ricardomdesa/espresso-mach-mod/pinout2-1500.png

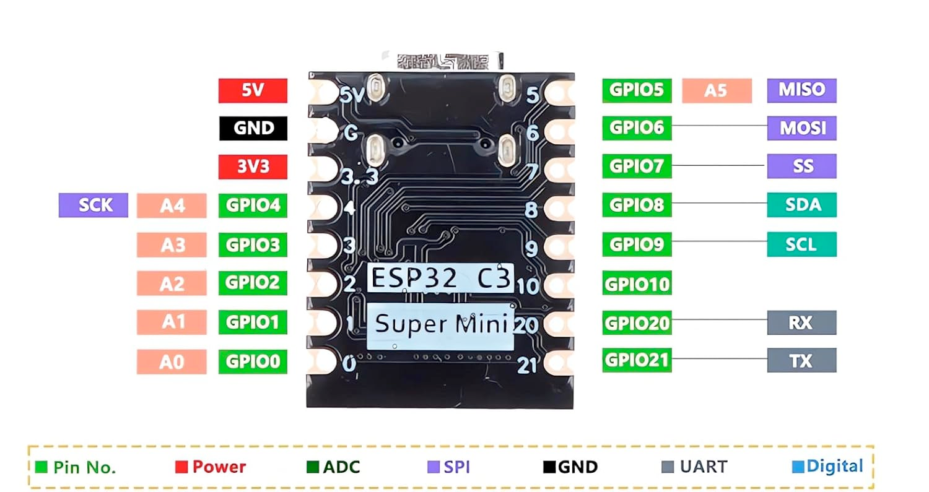
pinout2-1500.png
