ricardomdesa/espresso-mach-mod/hardware/espresso-board-mini/espresso-board-mini.step

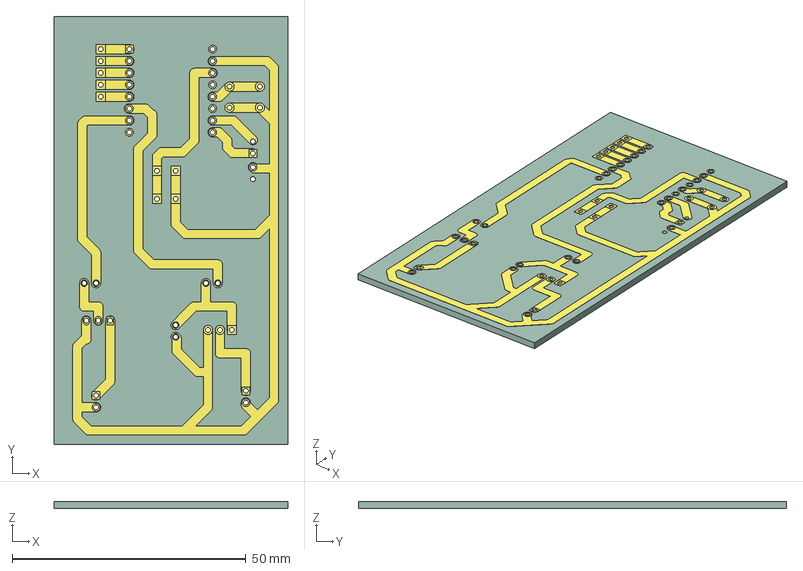
[picture p2: CAD file, 2026-09-21]
hardware/espresso-board-mini/espresso-board-mini.step
50.0 x 91.5 x 1.59 mm
espresso-board-mini-unsaved-export-MyEvqq_copper
espresso-board-mini-unsaved-export-MyEvqq_pad
espresso-board-mini-unsaved-export-MyEvqq_PCB
