ricardomdesa/espresso-mach-mod/hardware/step-down-V/step-down-V.kicad_pcb

## KiCad design hardware/step-down-V/step-down-V.kicad_pcb (2026-09-21)

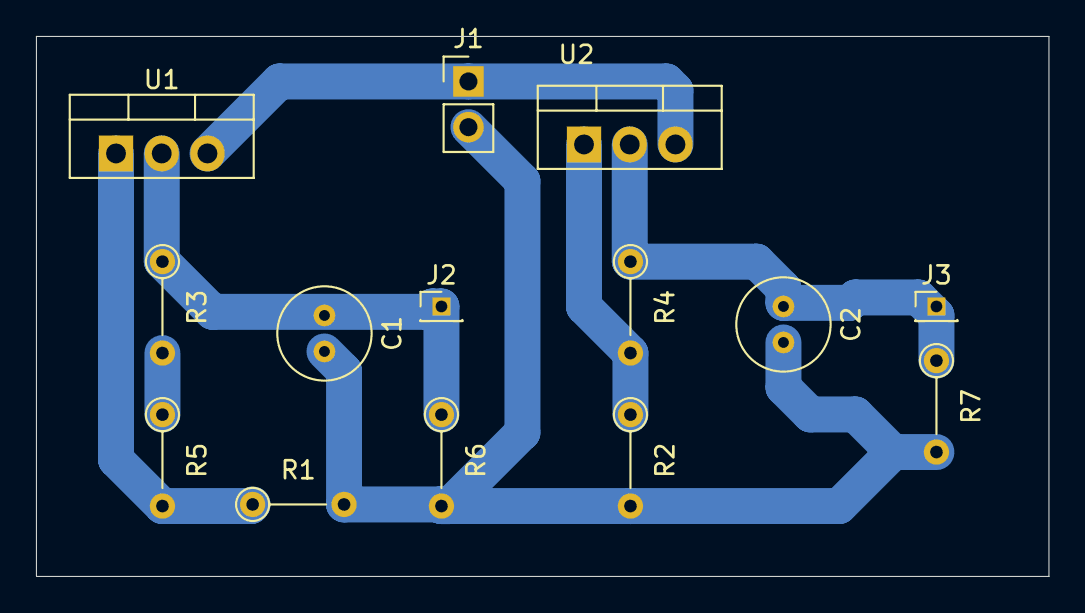
[picture p3: board step-down-V.kicad_pcb from above]

Board: 2 copper layers, 56.2 x 30.0 mm, 14 parts (0 on the bottom side), 7 nets.

Parts:
C1, C2: C_Polarized; C_Radial_D5.0mm_H5.0mm_P2.00mm
J1: Vin 12V; PinHeader_1x02_P2.54mm_Vertical
J2, J3: Conn_01x01_Socket; PinHeader_1x01_P1.27mm_Vertical
R1: 470; R_Axial_DIN0204_L3.6mm_D1.6mm_P5.08mm_Vertical
R2: 330; R_Axial_DIN0204_L3.6mm_D1.6mm_P5.08mm_Vertical
R3: 120; R_Axial_DIN0204_L3.6mm_D1.6mm_P5.08mm_Vertical
R4: 260; R_Axial_DIN0204_L3.6mm_D1.6mm_P5.08mm_Vertical
R5: 20; R_Axial_DIN0204_L3.6mm_D1.6mm_P5.08mm_Vertical
R6, R7: 1K; R_Axial_DIN0204_L3.6mm_D1.6mm_P5.08mm_Vertical
U1, U2: LM317_TO-220; TO-220-3_Vertical

Connections:
GND: C1.2, C2.2, J1.2, R1.2, R2.2, R6.2, R7.2
unnamed: J1.1, U1.3 (VI), U2.3 (VI)
unnamed: C1.1, J2.1 (Pin_1_1), R3.1, R6.1, U1.2 (VO)
unnamed: C2.1, J3.1 (Pin_1_1), R4.1, R7.1, U2.2 (VO)
unnamed: R3.2, R5.1
unnamed: R1.1, R5.2, U1.1 (ADJ)
unnamed: R2.1, R4.2, U2.1 (ADJ)
