ricardomdesa/espresso-mach-mod/hardware/espresso-board-mini/espresso-board-mini.kicad_pcb

## KiCad design hardware/espresso-board-mini/espresso-board-mini.kicad_pcb (2026-09-21)

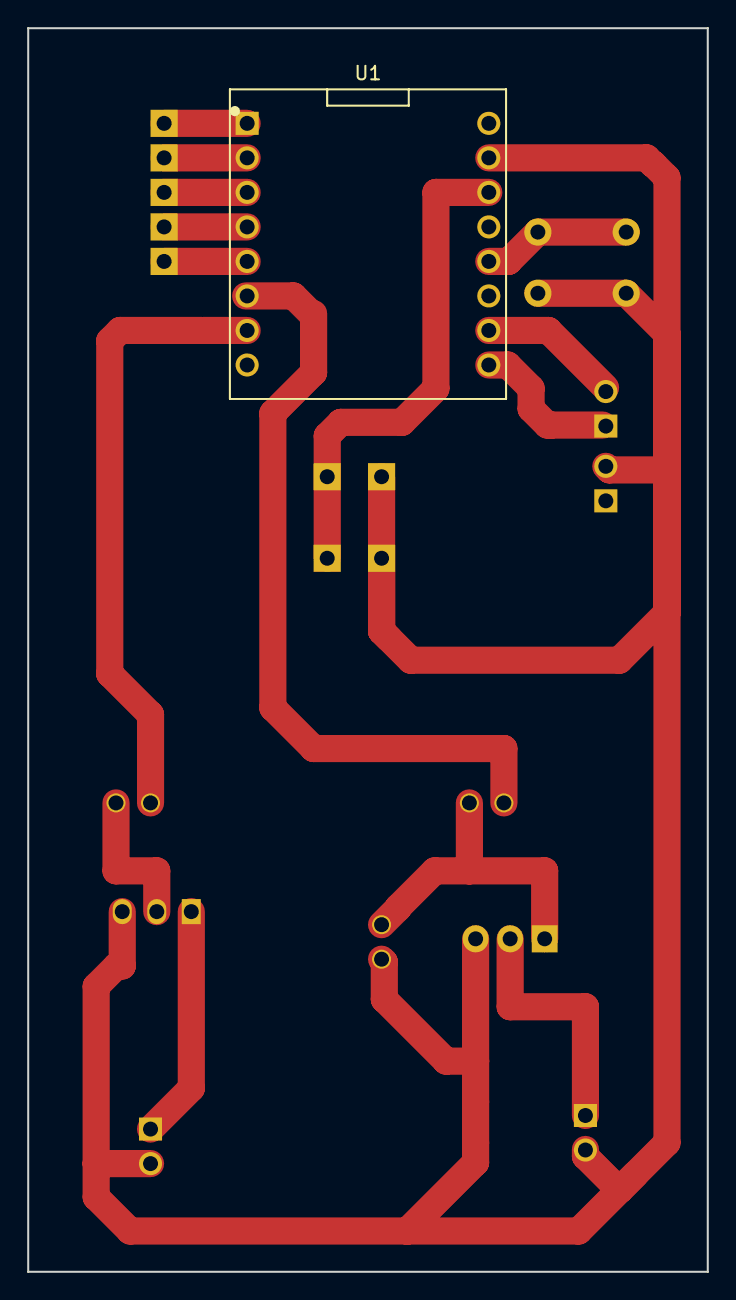
[picture p4: board espresso-board-mini.kicad_pcb from above]

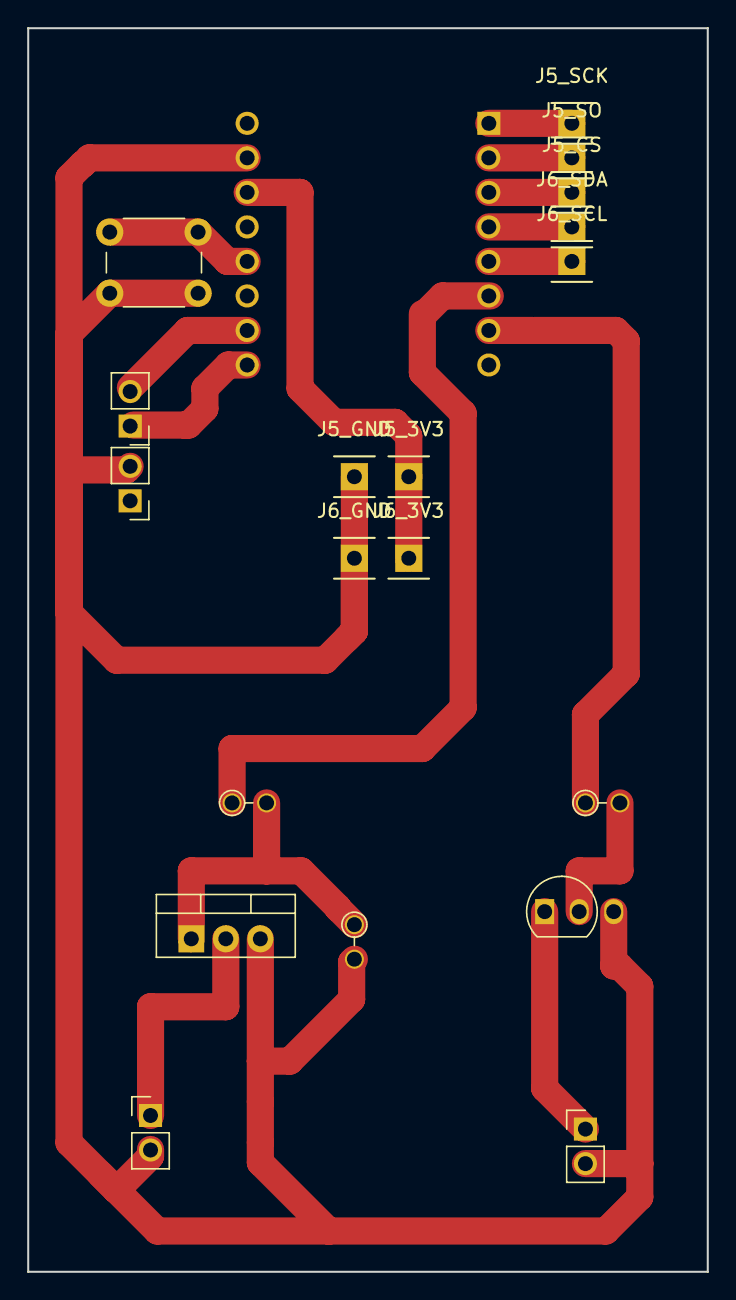
[picture p5: board espresso-board-mini.kicad_pcb from below]

Board: 2 copper layers, 50.0 x 91.5 mm, 10 parts (9 on the bottom side), 7 nets.

Parts:
J5_3V3: J_THERMO_3V3
J5_CS: THERMO_CS
J5_GND: J_THERMO_GND
J5_SCK: THERMO_SCK
J5_SO: THERMO_SO
J6_3V3: J_OLED_3V3
J6_GND: J_OLED_GND
J6_SCL: OLED_SCL
J6_SDA: OLED_SDA
U1: ESP32C3_SuperMini; ESP32C3_SuperMini_2x8_P2.54mm

Connections:
+3V3: J5_3V3.1, J6_3V3.1, U1.3 (3V3)
GND: J5_GND.1, J6_GND.1, U1.2 (GND)
OLED_SCL: J6_SCL.1, U1.13 (GPIO9)
OLED_SDA: J6_SDA.1, U1.12 (GPIO8)
THERMO_CS: J5_CS.1, U1.11 (GPIO7)
THERMO_SCK: J5_SCK.1, U1.9 (GPIO5)
THERMO_SO: J5_SO.1, U1.10 (GPIO6)
