ricardomdesa/espresso-mach-mod/hardware/espresso-board/espresso-board.kicad_pcb

## KiCad design hardware/espresso-board/espresso-board.kicad_pcb (2026-09-16)

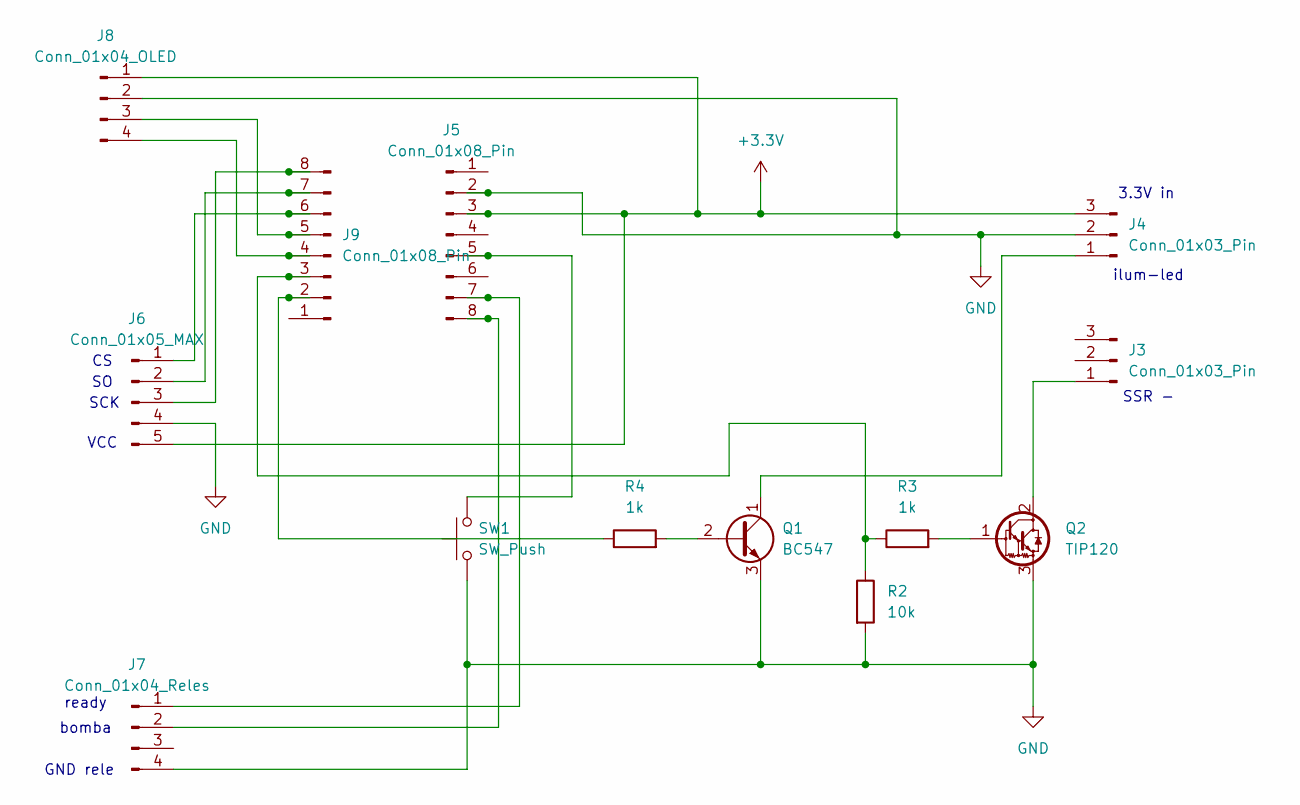
[picture p6: schematic espresso-board.kicad_sch]

Parts:
J3, J4: Conn_01x03_Pin; PinHeader_1x03_P2.54mm_Vertical
J5, J9: Conn_01x08_Pin; PinHeader_1x08_P2.54mm_Vertical
J6: Conn_01x05_MAX; PinHeader_1x05_P2.54mm_Vertical
J7: Conn_01x04_Reles; PinSocket_1x04_P2.54mm_Vertical
J8: Conn_01x04_OLED; PinSocket_1x04_P2.54mm_Vertical
Q1: BC547; TO-92_Inline
Q2: TIP120; TO-220-3_Vertical
R2: 10k; R_Axial_DIN0204_L3.6mm_D1.6mm_P2.54mm_Vertical
R3, R4: 1k; R_Axial_DIN0204_L3.6mm_D1.6mm_P2.54mm_Vertical
SW1: SW_Push; SW_PUSH_6mm

Connections:
+3.3V: J4.3, J5.3, J6.5, J8.1
GND: J4.2, J5.2, J6.4, J7.4, J8.2, Q1.3 (E), Q2.3 (E), R2.2, SW1.1
unnamed: J3.1 (Pin_1_1), Q2.2 (C)
unnamed: J4.1, Q1.1 (C)
unnamed: J5.5, SW1.2
unnamed: J5.7, J7.1
unnamed: J5.8, J7.2
unnamed: J6.1, J9.6
unnamed: J6.2, J9.7
unnamed: J6.3, J9.8
unnamed: J8.3, J9.5
unnamed: J8.4, J9.4
unnamed: J9.2, R4.1
unnamed: J9.3, R2.1, R3.1
unnamed: Q1.2 (B), R4.2
unnamed: Q2.1 (B), R3.2

Notes on the sheet:
ready
GND rele
SSR -
VCC
bomba
3.3V in
ilum-led
SCK

Board: 2 copper layers, 13 parts (1 on the bottom side), 16 nets, no tracks yet.
