ricardomdesa/espresso-mach-mod/include/pinos.h

#pragma once

// Pinagem validada em hardware (ESP32-C3 Super Mini) — mesma usada em outros
// projetos com este lote de placa.

// Único botão do produto. Clique curto liga/desliga o LED de iluminação; hold
// de 5 s sobe o AP de configuração (WifiProvisioner::requestAp). Ativo em LOW
// (pull-up interno, ligado ao GND).
#define PIN_BUTTON 3 // GPIO3 (botão tátil p/ GND, pull-up interno)

// GPIO20 é U0RXD por padrão. Com ARDUINO_USB_CDC_ON_BOOT=1 o Serial sai pelo
// USB-CDC, então a UART0 de hardware não é usada e o GPIO20 fica livre como
// saída digital. Não é strapping pin no ESP32-C3.
#define PIN_LED 20 // GPIO20 (saída p/ LED de iluminação, ativo HIGH)

// LED azul onboard da ESP32-C3 Super Mini: GPIO8, ativo em LOW. Usado como
// sinalizador de "modo setup" (pisca enquanto o AP está no ar). GPIO8 é
// strapping pin (precisa HIGH no boot) — só é dirigido depois do boot.
#define PIN_STATUS_LED 8
#define STATUS_LED_ON LOW
#define STATUS_LED_OFF HIGH

// Controle de temperatura: termopar tipo K via MAX6675 (SPI bit-bang) +
// SSR de aquecimento. Driver ativo no firmware (SensorMax6675 + PidController
// + HeaterOutput). A pressão segue em SensorFake — sensor de pressão é Fase 2.
#define PIN_THERMO_SCK 5 // GPIO5 — SPI SCK do amplificador do termopar (MAX6675)
#define PIN_THERMO_SO 6  // GPIO6 — SPI SO/MISO do amplificador (leitura)
#define PIN_THERMO_CS 7  // GPIO7 — SPI CS do amplificador

// GPIO10 -> driver TIP120 (Darlington NPN) que aciona o SSR GN 84136121
// (25A, entrada DC 3,5-32V). O GPIO só dá 3,3V e o datasheet do SSR pede
// min. 3,5V, por isso o estágio driver: GPIO10 --[1k]--> base do TIP120,
// resistor de 10k da base p/ GND (mantém o TIP120 cortado enquanto o GPIO
// flutua no boot). Coletor no "-" da entrada do SSR, emissor no GND comum,
// "+" da entrada do SSR no trilho de 5V (LM317 4,66V). Lógica não inverte:
// GPIO10 em HIGH satura o TIP120, puxa o "-" do SSR ao GND e o SSR conduz.
// Queda Vce(sat) do Darlington ~1V, o SSR vê ~3,6-4V — acima do limiar.
#define PIN_ACTUATOR 10 // GPIO10 — base do driver TIP120 do SSR de aquecimento (ativo HIGH)

// GPIO0 -> entrada de sinal do módulo de relé que aciona a bomba (liga/
// desliga). No ESP32-C3 o GPIO0 não é strapping pin (só serve de XTAL_32K_P,
// que não usamos), então fica livre como saída digital.
// O módulo de relé desta placa é ACTIVE-LOW: nível 0 fecha o relé (liga a
// bomba), nível 1 abre (desliga). GPIO0 tem pull-up interno no boot, então o
// relé fica desligado até o firmware assumir o pino.
#define PIN_PUMP 0      // GPIO0 — sinal do relé da bomba
#define PUMP_ACTIVE LOW // nível que liga a bomba (módulo active-low)
#define PUMP_IDLE HIGH  // nível que desliga a bomba

// GPIO1 -> relé "temperatura pronta". Fecha quando a caldeira chega no alvo
// (com histerese, ver controle.h) e abre se cair bem abaixo ou o sensor
// falhar. Serve pra extração manual sem o app: um contato seco sinalizando
// "pode puxar o shot". GPIO1 no ESP32-C3 é ADC1_CH1, sem função de strapping,
// livre como saída digital. Assume o MESMO módulo de relé active-low da bomba
// — A CONFIRMAR em bancada; se for active-high, inverter os dois defines.
#define PIN_READY 1       // GPIO1 — sinal do relé de "temperatura pronta"
#define READY_ACTIVE LOW  // nível que fecha o relé (temperatura ok)
#define READY_IDLE HIGH   // nível que abre o relé
