ricardomdesa/espresso-mach-mod/(commit log)

2026-08-19 feat: scaffold épico 1 — firmware OLED + navegação (ESP32-C3)
    Implementa SDD-001: driver SSD1306, DisplayModel como fonte única de
    dados, ScreenManager com 2 telas (leituras + cronômetro), Button com
    debounce/long-press, e SensorFake p/ validação sem hardware real.
    Validado em hardware: pio run limpo, upload OK, boot sem crash, scanner
    I2C detecta 0x3C. Achado durante implementação: Serial precisa de
    ARDUINO_USB_CDC_ON_BOOT=1 pro board rotear pro USB nativo (doc D6).
    Pendente: confirmação visual das telas e teste do botão físico (ainda
    não instalado).
    Claude-Session: https://claude.ai/code/session_011hTGmK6cLiQqmt3Grt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
    [Button.cpp, Button.h, DisplayModel.cpp, DisplayModel.h]
2026-08-19 fix: navegação da Tela 2 e layout das telas do OLED
    Long_press agora reseta o cronômetro e volta pra Tela 1 quando ativado
    na Tela 2 — sem isso não havia como sair do "modo timer" (bug achado em
    teste com botão físico, ver SDD-001 D7).
    Reorganiza layout das duas telas respeitando a fronteira física
    amarelo/azul do painel (y=16): texto grande não pode cruzá-la, senão
    fica ilegível (D8). Tela 1: setpoints pequenos em cima, temp/pressão
    grandes lado a lado embaixo. Tela 2: temp/pressão atuais na faixa
    amarela, cronômetro em destaque na azul.
    Validado em hardware real: build, boot, I2C, telas e botão (navegar,
    start/stop, reset) — todos os critérios de aceite da SDD-001 fec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
    [main.cpp]
2026-08-19 docs: SDDs dos épicos 2-4 (sensor temp, PID+bomba, integração)
    Refina EPICS.md (sensor de pressão adiado pra Fase 2, épico 2 só temperatura)
    e detalha os épicos 3-4 com o SSR real comprado (3-32VDC) e o vínculo
    timer/bomba. Épico 5+ segue sem SDD por decisão do projeto.
    Claude-Session: https://claude.ai/code/session_011hTGmK6cLiQqmt3GrtMfoa
2026-08-20 fix(app): corrige bugs da auditoria e aplica tema Latte
    Auditoria do scaffold (gerado por modelo anterior) encontrou 8 problemas em
    código marcado como concluído no SDD-007. 6 corrigidos aqui.
    Correções funcionais:
    - PID: `MachineStatus` não tinha o campo `pid` exigido pelo contrato SDD-006 F1,
    e SettingsScreen preenchia `kp` com o setpoint de temperatura. "Aplicar PID"
    gravava esse valor na caldeira. Campo adicionado ao tipo; a tela agora lê os
    ganhos reais. MachineContext passa a buscar `/api/status` ao abrir o WebSocket
    — antes nada chamava `refreshStatus()` no boot, então o status ficava nulo.
    - Editor de perfil: abria sempre com o formulário vazio, mesmo em modo edi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
2026-08-20 feat: épicos 5 e 6 — Wi-Fi, API REST/WebSocket e app conectando na máquina
    Fecha o caminho ESP32 <-> app: a máquina entra na rede do usuário e o app
    fala com ela. Antes o firmware não tinha rede nenhuma e o app abria em
    branco ao tentar conectar.
    Firmware (épico 5 — Wi-Fi + provisionamento)
    - WifiProvisioner próprio, sem WiFiManager: o portal cativo não é usado,
    quem coleta SSID/senha é o app via POST /api/wifi/provision.
    - O AP "Philco-Setup" fica ativo somente enquanto não há credencial. Ao
    recebê-la, grava na NVS, responde 200 e reinicia direto em STA.
    - mDNS philco.local; perda prolongada de STA reabre o AP.
    - GET /api/wifi/scan responde de um cache varrido em STA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
2026-08-20 feat(wifi): AP só via hold de 10s + tela de pareamento no OLED
    Segurança (regra do usuário): o AP de configuração nunca abre sozinho —
    nem no boot, nem por perda de STA. Ele só entra no ar com hold de 10 s do
    botão na tela inicial (barra de progresso no OLED), que seta uma flag
    one-shot na NVS e reinicia; o boot lê/limpa a flag e sobe o AP.
    - WifiProvisioner: estado Offline, requestAp() + force_ap na NVS, sem
    fallback automático de AP; loga reason code na desconexão STA.
    - OLED: indicador de rede (STA conectado / AP ativo / offline) e tela de
    pareamento (SSID/IP) que substitui a navegação normal enquanto o AP está no ar.
    - API: GET /api/status devolve wifiMode "offline" |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
2026-08-21 fix: aplica findings da code review (firmware, app web, Android)
    Firmware: gate de token X-Auth-Token nos endpoints mutantes, corrige
    overflow silencioso do serializeJson, race no scan de Wi-Fi, IDs de
    perfil colidindo entre boots, underflow no snprintf, barra de progresso
    do hold sendo apagada pelo redraw, SSID cortado na tela de pareamento.
    App web: envia X-Auth-Token nas chamadas mutantes e persiste o token
    recebido no provisionamento; libera o bind de Wi-Fi ao desconectar;
    corrige estado obsoleto no reconnect, badge de conexao preso em
    "Conectado" com WS caido, leak de setState apos unmount na tela de
    provisionamento, e mais alguns nits (input controlado, callback
    instavel, duracao x me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
    [ApiServer.cpp, ApiServer.h, WifiProvisioner.cpp, WifiProvisioner.h, main.cpp]
2026-08-24 feat(firmware): 2 botões, LED de iluminação e ajuste local de temperatura
    - Botão esquerdo (GPIO2): mantém navegação/timer/reset + hold 10 s abre AP.
    - Botão direito (GPIO3): clique liga/desliga LED; hold 5 s entra no ajuste de temperatura.
    - LED de iluminação (GPIO1): ligado por padrão no boot, não persistido.
    - Modo de ajuste: esquerdo -0.5 °C, direito +0.5 °C, auto-salva na NVS, long press sai.
    - Default de temperatura de fábrica: 93.0 -> 90.0 °C.
    - Pressão removida do OLED (continua no JSON/API para o app).
    [DisplayModel.h, main.cpp, pinos.h]
2026-08-24 fix(firmware): aplica findings da review do PR #2
    - Ajuste de temperatura grava na NVS só depois que o usuário para de mexer
    (kTempSaveDebounceMs = 2 s) ou ao sair do modo. Antes era uma escrita de
    flash por clique (90 -> 70 °C = 40 escritas) e cada open/put/close
    bloqueava o loop por alguns ms.
    - handleSetupHold + handleTempSetHold viram um handleHoldGesture só, com o
    estado em struct HoldGesture. Os contadores são zerados nos early returns
    do loop (AP e ajuste de temperatura): antes envelheciam em segundo plano e
    o gesto de 10 s podia abrir o AP sozinho ao voltar do modo de ajuste.
    Exclusão mútua entre os dois gestos: um hold por vez.
    - LED de iluminação sai de bool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
    [ApiServer.cpp, DisplayModel.h, main.cpp, pinos.h]
2026-08-27 feat(firmware): remove OLED e adiciona relé da bomba
    OLED SSD1306 queimou e saiu do projeto. Sem UI local: toda
    visualização/config passa a ser pelo app.
    Firmware:
    - Remove ScreenManager/Screens, libs Adafruit SSD1306/GFX e scanner I2C.
    - 1 botão físico (GPIO3): clique curto liga/desliga o LED de iluminação;
    hold de 5 s (era 10 s) sobe o AP de configuração.
    - LED de iluminação move para GPIO20 (era GPIO1).
    - LED azul onboard (GPIO8, ativo LOW) pisca a cada 2 s em modo AP como
    sinal de "setup".
    - Relé da bomba em GPIO0 (PIN_PUMP): estado lógico no DisplayModel,
    espelhado no GPIO pelo main.
    - WifiProvisioner: inicializa a pilha de rede no begin() (corrige assert
    lwip em f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
    [ApiServer.cpp, DisplayModel.h, WifiProvisioner.cpp, WifiProvisioner.h, main.cpp, pinos.h, rede.h]
2026-08-27 fix(firmware): bloqueia bomba/extração em modo AP e inverte nível do relé
    Findings do review do PR #3.
    - P1: em modo AP o loop principal bloqueia durante WiFi.scanNetworks()
    síncrono, então o espelho do GPIO da bomba (syncPump) só roda depois
    do scan — um "desligar" ficava pendente por segundos. Provisionamento
    não é modo operacional: /api/pump e /api/extraction/start agora
    respondem 409 quando wifi.mode() == Ap. /api/extraction/stop segue
    liberado. App: toggle Bomba e botão Iniciar extração desabilitados
    quando wifiMode === 'ap'.
    - Relé da bomba é active-low nesta placa: PUMP_ACTIVE = LOW,
    PUMP_IDLE = HIGH. Escreve IDLE antes do pinMode(OUTPUT) para não dar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
    [ApiServer.cpp, main.cpp, pinos.h]
2026-08-27 feat: perfil de temperatura + sequencia de bomba, executor no firmware
    App (Fase 1 sem controle de pressao):
    - perfil agora tem temperature_c + steps [{seconds, pump}] no lugar da
    curva de pressao; editor refeito (temp alvo + passos liga/desliga bomba
    com previa em linha do tempo)
    - pressao escondida da UI (dashboard, grafico, historico, unidades) —
    tipos e API mantidos pra Fase 2
    - tela Ajustes ganha card Maquina: IP e modo Wi-Fi (informativo)
    - dashboard mostra o nome do perfil ativo (nao o id) e grava o nome no
    historico; novo estado "preheating" no botao iniciar/parar
    - MachineMode::Preheating + flag no DisplayModel
    - ApiServer: executor de perfil — /api/extraction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
2026-08-27 feat(firmware): sensor de temperatura real (MAX6675) + PID + SSR
    Fecha a malha de temperatura, rodando desde o boot.
    Sensor (SDD-002):
    - SensorMax6675: adapter ISensor sobre adafruit/MAX6675, throttle 250ms,
    trata NAN/valor absurdo mantendo o ultimo valido (log limitado a 1/5s),
    expoe msSinceLastValidRead() pro failsafe
    - SensorCalibrated: decorator offset/ganho (include/calibracao.h, neutro)
    - main.cpp: tempSensor passa de SensorFake p/ SensorCalibrated(SensorMax6675);
    pressao continua fake (Fase 2)
    Controle (SDD-003):
    - PidController: PID posicional hand-rolled, so-aquecimento (saida e integral
    0..100%), anti-windup por clamp, derivada na medicao. Le Kp/Ki/Kd e
    setpoint do Disp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
2026-08-28 feat: modo vaporizacao (app + firmware) e teto de seguranca 115 C
    - DisplayModel ganha flag steaming_ (nao persiste) + MachineMode::Steaming
    e tempTarget() = TEMP_STEAM_C (90) quando ligado, senao o setpoint de cafe.
    - PidController persegue tempTarget().
    - ApiServer: PUT /api/steam {on} liga (sem escrita NVS) ou desliga (devolve o
    setpoint de cafe para TEMP_BREW_DEFAULT_C=70, persistido). Recusa 409 durante
    extracao/preheat; extraction/start limpa o modo. Campo "steam" no status JSON.
    - TEMP_MAX_SAFETY_C 130 -> 115. Faixa de /api/setpoint/temp e clamp de temp de
    perfil passam a usar o teto.
    App:
    - Nova tela Vaporizacao (rota /steam, item na BottomNav): mostrador de
    temp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
2026-08-29 feat(app): acesso offline e perfis com sync
    - rotas de perfis/ajustes/historico abrem sem a maquina; dashboard/steam
    reabrem offline quando ja houve pareamento (baseUrl conhecido)
    - cache local de perfis (Preferences) com marcas create/update/delete;
    syncProfiles empurra pendencias e recarrega a lista da maquina ao reconectar
    - badge "Offline" vira atalho para /setup; SetupScreen ganha links offline
    - NumberField com buffer de texto: remove o "0" preso nos campos de
    temperatura e duracao dos passos no editor de perfil
    - LiveChart: eixo Y passa a janela ~50-95 C (antes fixo 80-100, leitura
    colada na borda virava linha reta), com expansao se sair da faixa
    - SettingsScreen: aviso e boto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
2026-08-29 feat(firmware): relé "temperatura pronta" (GPIO1) + telemetria de debug do PID
    - PIN_READY (GPIO1): contato seco com histerese (READY_ON/OFF_MARGIN_C) em
    torno do alvo efetivo do PID, para extração manual sem o app. Sensor em
    falha força o relé aberto. main::syncReady espelha model.ready() no pino,
    latch pré-setado em IDLE antes do pinMode (mesmo cuidado da bomba).
    - DisplayModel: setControlDebug(duty, sensorAgeMs) escrito pelo main a cada
    loop; ready_ calculado em update(). mode() só reporta Heating quando abaixo
    do alvo (acima é coasting passivo, reporta Idle).
    - API: /api/status e /ws expõem ready, duty, target, sensAgeMs. JSON buffers
    736/288. App: DebugLine no Dashb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
2026-08-29 fix: aplica findings da code review do PR #6 (concorrência + segurança do aquecedor)
    - run_ com writer único (#1, #5): /api/extraction/start|stop nos handlers
    (task AsyncTCP) só erguem startReq_/stopReq_; ApiServer::loop() faz o
    start/stop de fato antes de serviceProfileRun(). Elimina a corrida em que
    um stop zerava run_.phase logo após o guard do executor e a bomba era
    religada sem timer. start ganha guard extracting_ -> 409 "extracao ja em
    andamento" (evita re-entrar em beginProfileRun, que regravava o setpoint
    na NVS e sobrescrevia run_).
    - SSR forçado desligado em modo AP (#2): WiFi.scanNetworks() é síncrono e
    bloqueia o loop por segundos; com o PID/SSR rodando desd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
    [ApiServer.cpp, ApiServer.h, main.cpp]
2026-08-29 feat(app): salva a curva de temperatura da extração no histórico
    - useLocalHistory: novo update(id, patch) pra editar um registro (ex.: notas).
    - DashboardScreen: ao encerrar o shot, amostra os frames pra ~120 pontos
    (1/s) e grava em samples[] + tempTarget no ExtractionRecord. 100 ms/frame
    cheio estouraria o Preferences com 500 registros.
    - LiveChart: aceita ChartPoint[] e desenha a linha tracejada do alvo do PID
    quando showTarget.
    - types.ts: ExtractionSample, samples[] e tempTarget em ExtractionRecord.
2026-08-29 feat: temperatura do vapor editável, entrada numérica de setpoint e cor por status
    - Alvo de vaporização deixa de ser fixo em TEMP_STEAM_C. DisplayModel ganha
    steamSetpoint_ (default 90 °C, NÃO persiste — volta a 90 no boot).
    tempTarget() usa steamSetpoint_ quando steaming.
    - PUT /api/steam aceita campo opcional {temp} (faixa TEMP_STEAM_MIN_C..
    TEMP_STEAM_MAX_C = 80..115). O setpoint de café só é devolvido a 70 °C na
    transição liga->desliga da vaporização, não a cada ajuste de alvo.
    - /api/status expõe steamSetpoint. kStatusJsonSize 768.
    - SettingsScreen: NumberField ao lado do slider de temperatura (acertar
    decimais no slider é difícil). Faixa a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
    [ApiServer.cpp, DisplayModel.cpp, DisplayModel.h, controle.h]
2026-08-29 feat(app): centraliza a leitura de temperatura e a linha de debug no dashboard
    Sem pressão exibida, a temperatura é a única leitura — centraliza o card
    (text-center, número em text-4xl) e a DebugLine (justify-center). Nenhum
    valor de pressão é mostrado no dashboard.
2026-08-30 feat(app): rebrand para "ESPresso" (ícone de grão de café + appId)
    - Ícone: grão de café torrado sobre fundo creme, gerado por @capacitor/assets
    a partir de assets/*.svg (adaptive icon + splash claro/escuro).
    - Nome de exibição "Philco Mod" -> "ESPresso" em capacitor.config.ts,
    strings.xml, index.html, título das telas Setup e Dashboard e README.
    - appId/namespace com.philco.mod -> com.rmdsistemas.espresso; código Java
    movido para com/rmdsistemas/espresso.
    - Removidos os vetores do ícone padrão do Capacitor (drawable/ic_launcher_*).
    Identificadores acoplados ao firmware seguem inalterados: host mDNS
    philco.local, SSID de provisionamento Philco-Setup e as chaves de
    armazena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
2026-08-31 docs(pinos): descreve driver TIP120 no GPIO10 do SSR de aquecimento
    Comentário apenas; PIN_ACTUATOR segue GPIO10 (ativo HIGH). Documenta o
    estágio driver: GPIO10 --[1k]--> base do TIP120, 10k base->GND (anti-boot),
    coletor no "-" da entrada do SSR, "+" no trilho 5V. Vce(sat) ~1V, SSR vê
    ~3,6-4V, acima do limiar de 3,5V.
2026-08-31 feat(simulator): API + tela web que emulam o ESP32
    Servidor em Go (dir simulator/) que expõe os mesmos endpoints REST e o
    WebSocket /ws do firmware (src/net/ApiServer.cpp), para o app rodar contra
    ele sem hardware — inclusive no emulador Android (endereço manual
    10.0.2.2:8080).
    - Contrato /api/* idêntico: status, setpoints, led/pump/steam, pid,
    extraction start/stop, profiles CRUD + active, wifi scan/provision/forget,
    factory-reset. Mesmo gate de X-Auth-Token, CORS "*" e OPTIONS 204.
    - Temperatura simulada por planta térmica de 1a ordem + PID posicional que
    é porte fiel de src/control/PidController.cpp (anti-windup, derivada sobre
    a medição, failsafes de leitura parada e so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
2026-08-31 fix(simulator): remove frontend syntax e usa scratch no Dockerfile
    A diretiva "# syntax=docker/dockerfile:1" forçava o buildkit a puxar a
    imagem do frontend de docker.io e estourava o timeout em rede ruim
    (DeadlineExceeded). Nada no Dockerfile precisa do frontend externo.
    Estágio final passa a ser FROM scratch: o binário é estático e o simulador
    não faz TLS de saída nem usa shell. Imagem final ~5 MB.
2026-08-31 fix(app): alvo da vaporizacao so editavel com o vapor desligado
    O botao de lapis (editar alvo) ficava habilitado tambem com a vaporizacao
    ligada, o que confundia: o valor ate era aplicado, mas nao ficava claro
    quando passava a valer. Agora:
    - botao desabilitado enquanto steaming (com title explicativo);
    - se ligar o vapor com o editor aberto, ele fecha;
    - texto de ajuda deixa claro que o alvo se ajusta com o vapor desligado e
    passa a valer ao ligar.
2026-08-31 chore(app): libera cleartext p/ hosts de emulador (testes com o simulador)
    Adiciona 10.0.2.2 / 10.0.3.2 / localhost / 127.0.0.1 ao domain-config de
    cleartext, para o app rodar no emulador Android (e via `adb reverse` no
    celular) contra o simulador do ESP32 (simulator/) servido no host. Inocuo
    em producao: o app nunca contata esses enderecos num aparelho real.
2026-09-01 docs: adiciona README público do projeto ESPresso
    Visão geral, hardware/pinagem, instruções de build (firmware/app/simulador),
    tabela da API REST/WS, roadmap por épico e aviso de segurança AC.
2026-09-01 feat(auth): troca token dinâmico por código de pareamento fixo
    A API exigia um token de 32 hex gerado aleatoriamente e persistido na NVS
    no primeiro boot, entregue ao app só na resposta de /api/wifi/provision.
    Reinstalar o app ou trocar de celular deixava as chamadas mutantes em
    "token invalido" para sempre, sem forma de recuperar o token em modo STA.
    Agora a chave é fixa: um "código de pareamento" da máquina (12 hex),
    compilado no firmware via API_AUTH_KEY (platformio.ini) e impresso no
    Serial no boot — como a senha na etiqueta de um roteador. O app pede esse
    código uma vez, na tela de Setup, e guarda no aparelho
    (@capacitor/preferences); daí em diante vai no header X-Auth-Token.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
    [ApiServer.cpp, ApiServer.h]
2026-09-01 fix(auth): remove fallback de API_AUTH_KEY compilado no firmware
    O `#ifndef` usava o mesmo valor do exemplo commitado no platformio.ini.
    Compilar sem `-D API_AUTH_KEY` embarcava um código de pareamento que já
    está público no histórico do repositório.
    Agora o build falha com `#error` quando o flag não é definido.
    [ApiServer.cpp]
2026-09-01 fix(app): reconecta ao ESP32 depois do bloqueio de tela
    Ao desbloquear o celular a conexao com a maquina ficava morta em definitivo:
    so matando e reabrindo o app ela voltava.
    useWebSocket desistia depois de MAX_RECONNECT_ATTEMPTS (10 x 3s). Com a tela
    bloqueada o Android congela os timers da WebView; ao desbloquear os setTimeout
    acumulados disparavam em rajada enquanto a Wi-Fi ainda reassociava, queimando
    as 10 tentativas em segundos. Depois disso `onclose` nunca mais reagendava, e
    `attempts` so zerava em `onopen` ou num remount do efeito -- que nunca vinha,
    porque `wsUrl` depende de baseUrl+connected e nenhum dos dois mudava.
    - backoff exponencial 1s->30s, sem teto de tentativas
    - heartbe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
2026-09-01 feat(ios): projeto iOS e NetworkBinder nativo
    Adiciona a plataforma iOS (@capacitor/ios, iosScheme http para o cleartext
    HTTP/WS da maquina) e a contraparte Swift do NetworkBinder.
    O iOS nao tem equivalente a bindProcessToNetwork(): quem escolhe a interface
    e o sistema, e o WKWebView usa a URLSession dele -- entao bind()/unbind() sao
    no-op honestos (`requested: false`). O que faltava de verdade era o
    diagnostico: sem o plugin, NetworkBinder.status() rejeitava e
    diagnoseNetwork() devolvia null, entao a tela de conexao nunca conseguia dizer
    por que a maquina nao responde.
    - status() via NWPathMonitor: wifiAvailable pelas interfaces disponiveis e
    `bound` = a rota em uso passa pela Wi-Fi (eq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
2026-09-01 fix(auth): exige o codigo de pareamento em vez de cair no painel em leitura
    /api/status e publico, entao o app "conectava" sem codigo nenhum: o
    auto-discover roda no mount do SetupScreen com o campo ainda vazio, o
    getStatus respondia 200, `connected` virava true e o efeito redirecionava
    para o painel. O usuario so descobria o problema no primeiro comando, com um
    401 solto na tela.
    Aparecia primeiro no iOS porque o passo 1 do discovery e `http://philco.local`:
    o iOS resolve .local pelo mDNSResponder, o Android nao tem resolver mDNS no
    stack padrao e caia na varredura de subnet, que falhava e deixava o usuario
    digitar o codigo. Nao era diferenca de plataforma -- era o auto-discover
    conectando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
    [ApiServer.cpp]
2026-09-01 fix(ios): trava o zoom da WebView
    Um pinch acidental no painel deixava a tela ampliada e cortada nas bordas, e a
    WKWebView guardava a escala entre sessoes -- so reabrindo o app voltava ao
    normal.
    A meta viewport sozinha nao segura o pinch na WKWebView, entao o zoom e
    travado tambem na scrollView. Num painel de controle nao ha nada para ampliar:
    o layout ja e responsivo.
    - MainViewController: minimum/maximumZoomScale em 1, bouncesZoom desligado e
    pinchGestureRecognizer desabilitado
    - index.html: maximum-scale=1.0 e user-scalable=no na meta viewport
2026-09-01 chore(auth): tira o codigo de pareamento do repositorio
    O repositorio e publico e o codigo estava versionado em platformio.ini, num
    build flag. Quem lesse o repo comandava a maquina: bomba, setpoint, extracao.
    O placeholder do campo no Setup ainda repetia o mesmo valor como "exemplo".
    - platformio.ini passa a ler o codigo de secrets.ini via extra_configs;
    secrets.ini esta no .gitignore
    - secrets.ini.example versionado, com instrucao de gerar o codigo
    (openssl rand -hex 6)
    - static_assert de tamanho minimo em ApiServer.cpp: secrets.ini ausente ou com
    auth_key vazio faz `${secrets.auth_key}` expandir para nada, e um header
    X-Auth-Token vazio abriria a maquina inteira. Agora o build fa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
2026-09-01 docs: explica como criar o secrets.ini antes do primeiro build
    O arquivo e criado a mao pelo usuario e o build falha sem ele, mas isso so
    estava escrito no comentario do platformio.ini e no proprio
    secrets.ini.example -- quem clonava o repo batia no erro de compilacao sem
    saber o motivo.
    - passo a passo na secao Firmware (cp do example + openssl rand -hex 6), com o
    porque de nao ser versionado
    - secrets.ini.example na arvore do repositorio
    - secao API: registra /api/auth/check e deixa claro que as rotas de leitura sao
    publicas -- da para ver as leituras sem codigo, mas nao comandar
2026-09-04 docs: adiciona SDD-008 do diario do barista
    Registro estruturado das extracoes: preparo antes do shot, avaliacao
    depois, cadastro de graos e linhagem entre shots. Storage local
    reorganizado (indice + shard por shot, fotos no Filesystem); contrato
    da API do ESP32 nao muda.
2026-09-04 feat(diario): tipos do diario e plugins de camera/filesystem
    Épico 8 fase 1, tasks 1-2 (docs/sdd/008-diario-do-barista.md):
    ShotStatus/ShotLog/ShotPhoto/ShotRecord/ShotIndexEntry/Bean em
    api/types.ts, instala @capacitor/camera e @capacitor/filesystem,
    declara permissao CAMERA no manifesto Android e sincroniza os
    plugins nativos.
    Claude-Session: https://claude.ai/code/session_012bFmiNCQjQ6ukm1svvUiNC
2026-09-04 feat(diario): shotRepository, photoStore e derived.ts
    Épico 8 fase 1, tasks 3-5:
    - shotRepository.ts: indice + shard por shot (D5), rascunho unico (D3),
    bindExtraction como unico ponto de juncao maquina/diario (D2), migrate()
    idempotente do schema 1 pro 2 (RF-23/RF-24).
    - photoStore.ts: captura via Camera comprimida na origem (RNF-02),
    gravacao/leitura/remocao via Filesystem, varredura de fotos orfas (R3).
    - derived.ts: ratio, flowRate, restDays e diffShots — todos calculados na
    renderizacao, nunca persistidos (D9).
    - App.tsx roda migrate() antes da primeira renderizacao e dispara a
    varredura de orfaos em segundo plano.
    Cl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
2026-09-04 feat(diario): useShots substitui useLocalHistory, testes de vitest
    Épico 8 fase 1, tasks 6-7 (docs/sdd/008-diario-do-barista.md):
    - useShots.ts troca useLocalHistory em HistoryScreen e DashboardScreen
    sem alterar a interface visivel; useLocalHistory.ts removido.
    - vitest instalado; testes cobrem migrate (idempotencia, legacyNotes,
    chave antiga preservada), rascunho unico, bindExtraction com/sem
    rascunho, reindexacao e derived.ts (ratio/flowRate/restDays/diffShots).
    23 testes verdes.
    - Corrige restDays() para comparar datas em UTC (bug de fuso horario
    pego pelo proprio teste).
    Fase 1 completa: app se comporta como antes, dados ja no schema 2.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
2026-09-04 fix(diario): corrige achados da review do PR 15
    - shotRepository: writeIndex agora limpa shards excedentes ao capar em
    500 (paridade com o antigo useLocalHistory), clearAll() apaga tudo
    numa passada so (sem N removeShot() concorrentes disputando o mesmo
    indice) e openDraft() serializa via lock para nao criar dois
    rascunhos com toques/efeitos concorrentes.
    - useShots: add() passa a chamar bindExtraction (unico ponto de juncao
    maquina/diario, D2) em vez de gravar um shot 'done' direto; update()
    vira updateNotes(), gravando em log.notes em vez de duplicar notes
    na raiz do shot.
    - DashboardScreen: para de gerar id/date manualmente, deixa
    bindExtraction cuidar disso.
    - HistoryScre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
2026-09-05 feat(diario): preparo e ciclo de vida do rascunho (Fase 2) (#16)
    * feat(diario): preparo e ciclo de vida do rascunho (Fase 2)
    useDraft, PrepScreen, GrindStepper e DraftChip abrem o fluxo de preparo
    (SDD-008 itens 8-9); "concluir sem curva" fecha o rascunho sem extracao
    pelo app (RF-11); BottomNav ganha contador de pending_review (item 12).
    * fix(diario): corrige achados da review da Fase 2
    - serializa saveShot no useDraft pra evitar write concorrente reverter o rascunho
    - PrepScreen nao trava mais em "Carregando" se openDraft perder a race
    - badge de pending-rev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
2026-09-05 feat(diario): avaliacao, fotos e historico por indice (Fase 3) (#17)
    * feat(diario): avaliacao, fotos e historico por indice (Fase 3)
    Introduz PhotoPicker (captura/remove por fase, teto de 6/shot) e TasteTags
    (sabor multi-selecao); ShotDetailScreen reune curva, avaliacao (yield,
    1a gota, canalizacao, nota, observacoes, "mudar na proxima") e fotos, com
    ratio/vazao exibidos e nunca persistidos (D9) e legacyNotes mostrado como
    "anotacao original" (RF-23). HistoryScreen passa a ler so o indice
    (ShotCard com miniatura lazy), sem carregar curvas (RNF-01); useShots
    encolhe pro unico uso que resta (bindExtraction no dashboard).
    Claude-Session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
2026-09-16 pcb first version
    [espresso-board-mini.kicad_pcb, espresso-board-mini.kicad_sch, espresso-board-mini.step, espresso-board.kicad_pcb, espresso-board.kicad_sch]
2026-09-16 feat(hardware): ajustes de furo e footprints no espresso-board-mini
    [espresso-board-mini.kicad_pcb, espresso-board-mini.step]
2026-09-16 fix(hardware): padroniza furação do espresso-board-mini para 1.1mm
    Todos os drills de pad THT ajustados para 1.1mm. Pads do TO-92
    (0.75mm) tiveram o size alargado de 1.05x1.5 para 1.4x1.85 para
    manter anel de cobre válido com o furo maior.
    [espresso-board-mini.kicad_pcb]
2026-09-16 fix(hardware): re-exporta STEP do espresso-board-mini com roteamento correto
    Havia uma tentativa manual de mover o roteamento para B.Cu que deixou
    45 pontas de trilha desconectadas de qualquer pad. Placa e cobre em
    uma face só (F.Cu), então o roteamento correto e ja comitado
    permanece nessa camada. STEP regenerado a partir do PCB revertido,
    sem o redesenho quebrado.
    [espresso-board-mini.step]
2026-09-21 fix(hardware): atualiza roteamento e reexporta STEP do espresso-board-mini
    Adiciona .gitignore para lockfiles KiCad (*.lck).
    [espresso-board-mini.kicad_pcb, espresso-board-mini.step]
2026-09-21 feat(hardware): adiciona projeto step-down-V
    [step-down-V.kicad_pcb, step-down-V.kicad_sch]
